alexandervolikov/spotiduino_v1/README.md

Sportiduino_v1

v. 1.6.0.

Данная версия используется мной для моих станций, имеется некоторая специфика работы а также элементы, несовместимые с основной версией.

Общеподдерживаямая версия находится тут: https://github.com/sportiduino/sportiduino
