alexandervolikov/spotiduino_v1/SportiduinoPQ/CHANGELOG.md

## [0.6.2] - 2020-10-23
### change some functions for version 1.5.0 sportiduino

## [0.6.1] - 2018-10-23
### del some functions for version 1.4.2 sportiduino

## [0.6.0] - 2018-10-03
### add function for sportiduino v.1.4.0

## [0.5.0] - 2018-09-26
### del some function

## [0.4.1] - 2018-07-16
### add force start time
- add force for correct split print

## [0.4.0] - 2018-07-09
### add gpx
- calc split with use gpx format file

## [0.3.1] - 2018-07-08
### Correct split format

## [0.3.0] - 2018-07-06
### Add split Printer

## [0.2.1] - 2018-07-04
### Some minor fixes

## [0.2.0] - 2018-07-04
### Add save data to json
- save data from card to json format file
- save data from dump card to json format file
- some fixes

## [0.1.1] - 2018-07-03
### Fix set time bag

## [0.1.0] - 2018-07-03
### First version
