alexandervolikov/spotiduino_v1/hardware/base_station/src/sportiduino-base.kicad_pcb

## KiCad design hardware/base_station/src/sportiduino-base.kicad_pcb (2021-09-12)

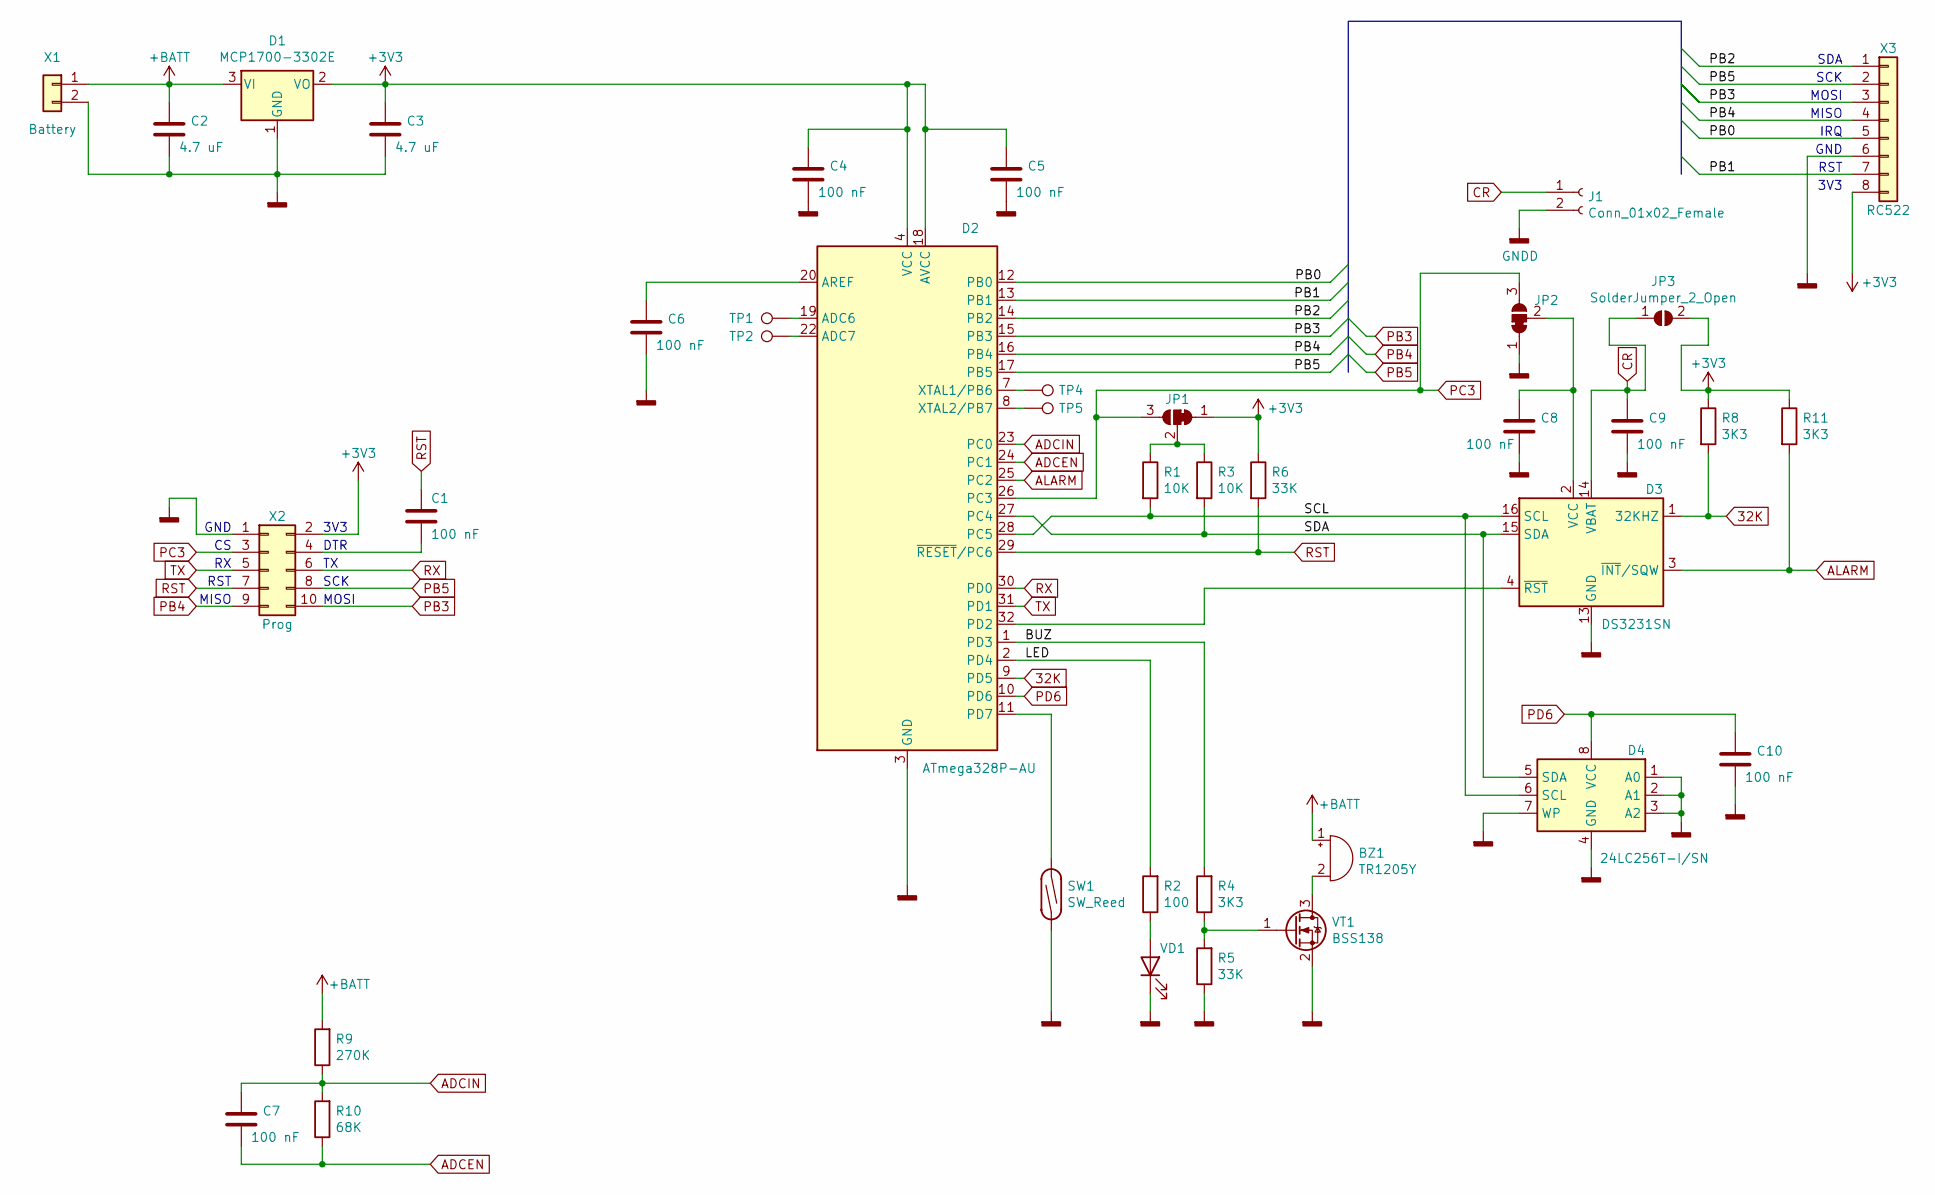
[picture p1: schematic sportiduino-base.sch, Sportiduino Base Station]

Parts:
BZ1: TR1205Y; MagneticBuzzer_ProSignal_ABT-410-RC
C1, C4, C5, C6, C7, C8, C9, C10: 100 nF; C_0805_2012Metric_Pad1.15x1.40mm_HandSolder
C2, C3: 4.7 uF; C_0805_2012Metric_Pad1.15x1.40mm_HandSolder
D1: MCP1700-3302E; SOT-23_Handsoldering
D2: ATmega328P-AU; TQFP-32_7x7mm_P0.8mm
D3: DS3231SN; SOIC-16W_7.5x10.3mm_P1.27mm
D4: 24LC256T-I/SN; SOIC-8_3.9x4.9mm_P1.27mm
J1: Conn_01x02_Female; PinHeader_1x02_P2.54mm_Vertical
JP1, JP2: SolderJumper_3_Bridged12; SolderJumper-3_P1.3mm_Open_RoundedPad1.0x1.5mm_NumberLabels
JP3: SolderJumper_2_Open; SolderJumper-2_P1.3mm_Open_RoundedPad1.0x1.5mm
R1, R3: 10K; R_0805_2012Metric_Pad1.15x1.40mm_HandSolder
R2: 100; R_0805_2012Metric_Pad1.15x1.40mm_HandSolder
R4, R8, R11: 3K3; R_0805_2012Metric_Pad1.15x1.40mm_HandSolder
R5, R6: 33K; R_0805_2012Metric_Pad1.15x1.40mm_HandSolder
R9: 270K; R_0805_2012Metric_Pad1.15x1.40mm_HandSolder
R10: 68K; R_0805_2012Metric_Pad1.15x1.40mm_HandSolder
SW1: SW_Reed; SW_reed
TP1, TP2, TP4, TP5: TestPoint; TestPoint_THTPad_D1.5mm_Drill0.7mm
VD1: 3mm; LED_D3.0mm
VT1: BSS138; SOT-23_Handsoldering
X1: Battery; PinHeader_1x02_P2.54mm_Vertical
X2: Prog; IDC-Header_2x05_P2.54mm_Vertical
X3: RC522; PinHeader_1x08_P2.54mm_Vertical

Connections:
32K: D2.9 (PD5), D3.1 (32KHZ), R8.2
+3V3: C3.1, C4.1, C5.1, D1.2 (VO), D2.4 (VCC), D2.6 (VCC), D2.18 (AVCC), JP1.1 (A), JP3.2 (B), R6.1, R8.1, R11.1, X2.2, X3.8
+BATT: BZ1.1 (-), C2.1, D1.3 (VI), R9.2, X1.1
/BUZ: D2.1 (PD3), R4.2
/LED: D2.2 (PD4), R2.2
/PB0: D2.12 (PB0), X3.5
/PB1: D2.13 (PB1), X3.7
/PB2: D2.14 (PB2), X3.1
/SCL: D2.28 (PC5), D3.16 (SCL), D4.6 (SCL), R1.2
/SDA: D2.27 (PC4), D3.15 (SDA), D4.5 (SDA), R3.2
ADCEN: C7.2, D2.24 (PC1), R10.1
ADCIN: C7.1, D2.23 (PC0), R9.1, R10.2
ALARM: D2.25 (PC2), D3.3 (~INT~/SQW), R11.2
CR: C9.1, D3.14 (VBAT), J1.1, JP3.1 (A)
GNDD: C2.2, C3.2, C4.2, C5.2, C6.2, C8.2, C9.2, C10.2, D1.1 (GND), D2.3 (GND), D2.5 (GND), D2.21 (GND), D3.5 (GND), D3.6 (GND), D3.7 (GND), D3.8 (GND), D3.9 (GND), D3.10 (GND), D3.11 (GND), D3.12 (GND), D3.13 (GND), D4.1 (A0), D4.2 (A1), D4.3 (A2), D4.4 (GND), D4.7 (WP), J1.2, JP2.1 (A), R5.1, SW1.2, VD1.1 (K), VT1.2 (S), X1.2, X2.1, X3.6
unnamed: BZ1.2 (+), VT1.3 (D)
unnamed: C1.2, X2.4
unnamed: C6.1, D2.20 (AREF)
unnamed: C8.1, D3.2 (VCC), JP2.2 (C)
unnamed: D2.7 (XTAL1/PB6), TP4.1
unnamed: D2.8 (XTAL2/PB7), TP5.1
unnamed: D2.11 (PD7), SW1.1
unnamed: D2.19 (ADC6), TP1.1
unnamed: D2.22 (ADC7), TP2.1
unnamed: D2.32 (PD2), D3.4 (~RST)
unnamed: JP1.2 (C), R1.1, R3.1
unnamed: R2.1, VD1.2 (A)
unnamed: R4.1, R5.2, VT1.1 (G)
PB3: D2.15 (PB3), X2.10, X3.3
PB4: D2.16 (PB4), X2.9, X3.4
PB5: D2.17 (PB5), X2.8, X3.2
PC3: D2.26 (PC3), JP1.3 (B), JP2.3 (B), X2.3
PD6: C10.1, D2.10 (PD6), D4.8 (VCC)
RST: C1.1, D2.29 (~RESET~/PC6), R6.2, X2.7
RX: D2.30 (PD0), X2.6
TX: D2.31 (PD1), X2.5

Notes on the sheet:
RST
GND
IRQ
MISO
MOSI
SCK
SDA
3V3
DTR

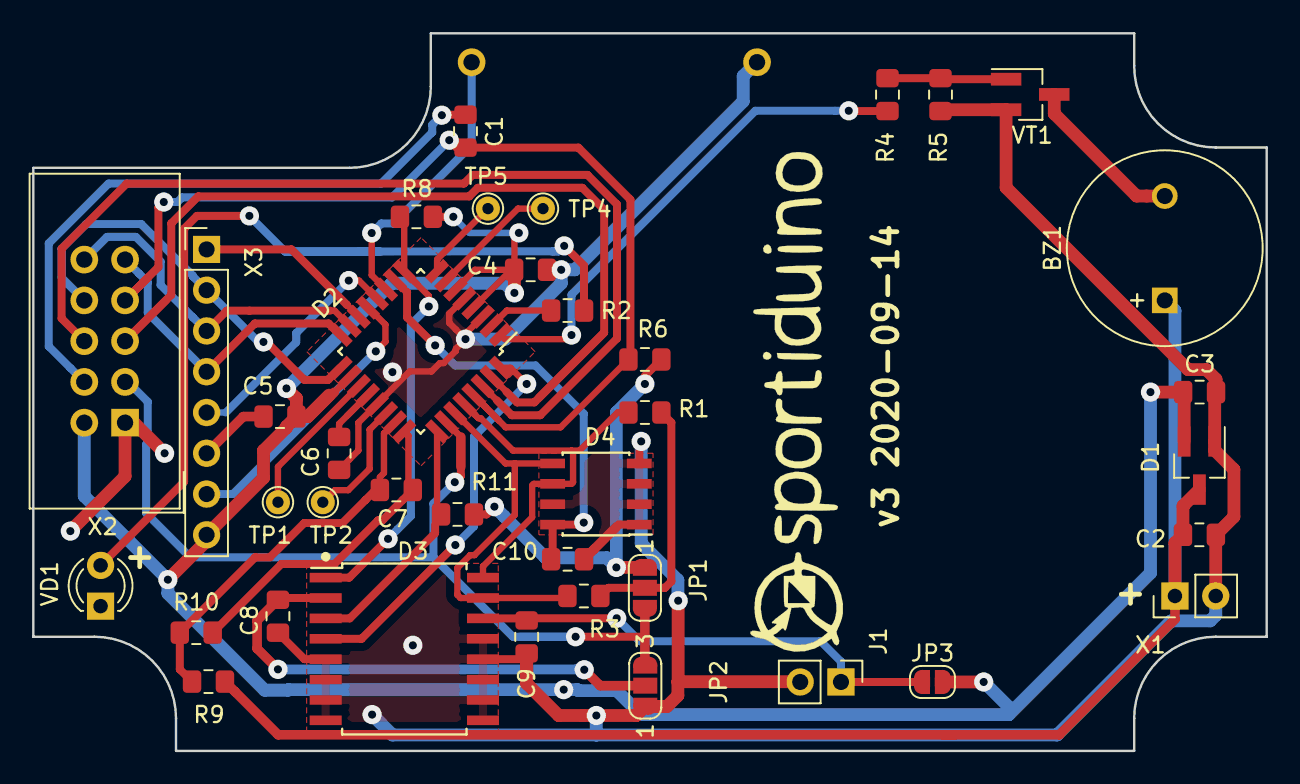
[picture p2: board sportiduino-base.kicad_pcb from above]

Board: 2 copper layers, 76.8 x 44.7 mm, 39 parts (1 on the bottom side), 36 nets.
