alexandervolikov/spotiduino_v1/(commit log)

2020-10-25 v. 1.5.0
    [memory.xlsx, sportiduino-base-bom.csv, sportiduino-base.kicad_pcb, sportiduino-base.sch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]
2020-10-25 add chip and version info to init
    [memory.xlsx]
2020-10-25 add separate ntag password
    [memory.xlsx]
